Skullmachine/CarteHFProjet4A/README.md

CarteHFProjet3A
===============

Création d'une carte electronique 3A Polytech'tours
