Skullmachine/CarteHFProjet4A/Composants/Commande_Projet_HF.numbers/preview-web.jpg

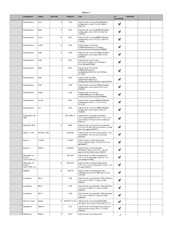
Composants/Commande_Projet_HF.numbers/preview-web.jpg
