Skullmachine/CarteHFProjet4A/CompteRendu/1450908_897423956975424_7267773935941642261_n.jpg

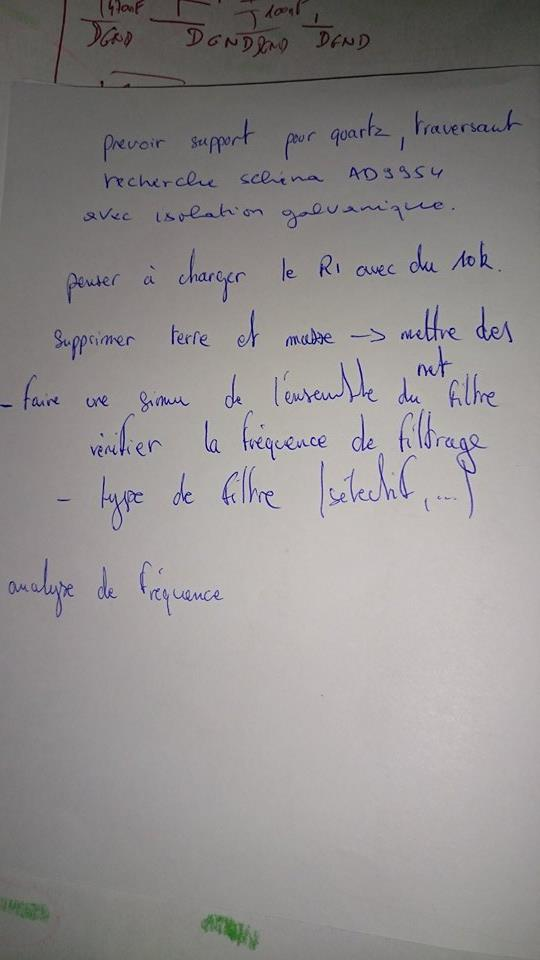
CompteRendu/1450908_897423956975424_7267773935941642261_n.jpg
