Skullmachine/CarteHFProjet4A/CompteRendu/11021189_897423016975518_8215299613850829258_n.jpg

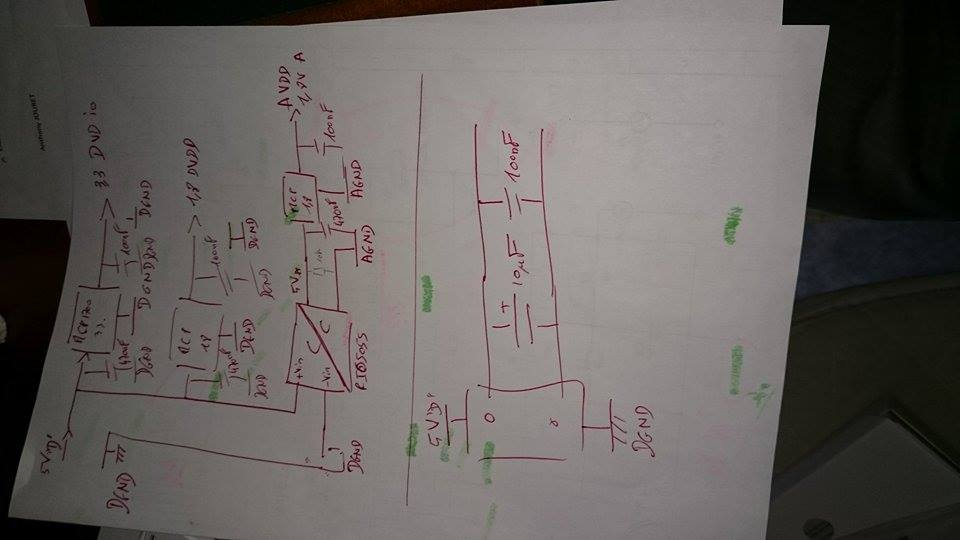
CompteRendu/11021189_897423016975518_8215299613850829258_n.jpg
