Skullmachine/CarteHFProjet4A/CompteRendu/11025787_897423990308754_809297115763388734_n.jpg

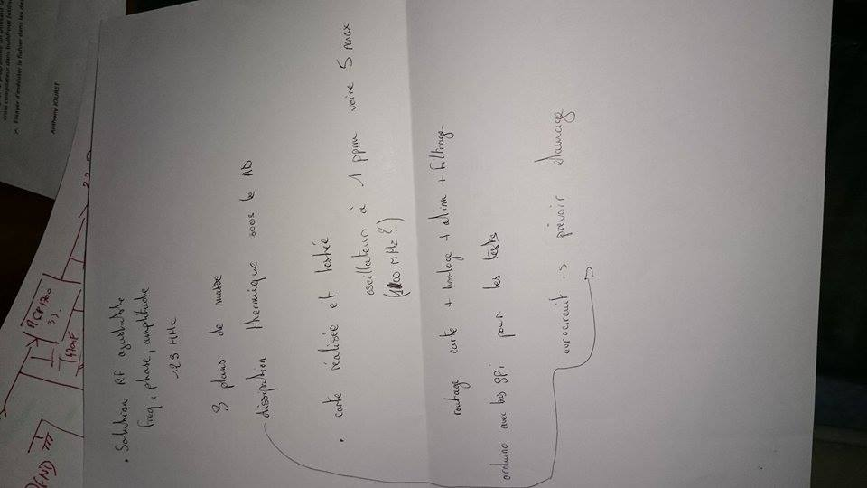
CompteRendu/11025787_897423990308754_809297115763388734_n.jpg
