Skullmachine/CarteHFProjet4A/CompteRendu/modele/images/schema.PNG

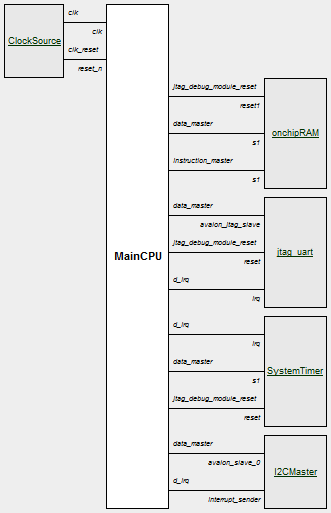
CompteRendu/modele/images/schema.PNG
