Skullmachine/CarteHFProjet4A/CompteRendu/schema_struct_anoté.jpg

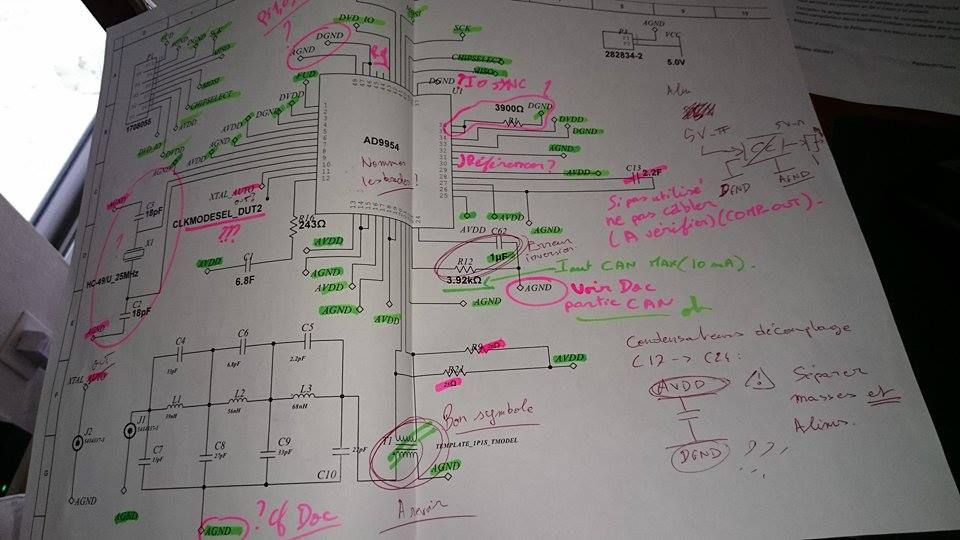
CompteRendu/schema_struct_anoté.jpg
