Skullmachine/CarteHFProjet4A/Composants/Commande Farnell 2.xlsx

Fournisseur | Nom | FARNELL
 | Adresse
Etudiants | Promotion | DII4 |  | Encadrant | Nom | BARANTN
 | Noms | ARTUS | MIKIELA
Projet | Type | Electronique
 | Identifiant (titre ou Id) | 80
N° nom. | Références | Devis | Désignation produits, prestations |  | N°inventaire | Montant unitaire H.T. | Quantité | Montant H.T. | Montant T.V.A. | Montant T.T.C.
 | 2333546RL |  | BOURNS - CR1206-JW-103ELF - RESISTANCE COUCHE EPAISSE 10K 5% 1206 |  |  | 0.045 € | 2 | 0.090 € | 0.018 € | 0.108 €
 | 1754222 |  | VISHAY SPRAGUE - 293D474X9035A2TE3 - CONDENSATEUR TANTALE 470NF 35V BOITIER A |  |  | 0.207 € | 5 | 1.035 € | 0.207 € | 1.242 €
 | 2326128 |  | PANASONIC ELECTRONIC COMPONENTS - EEE1EA100WAR - CONDENSATEUR ELEC ALU 10UF 25V CMS |  |  | 0.160 € | 2 | 0.320 € | 0.064 € | 0.384 €
 |  |  |  |  |  |  |  | 0.000 € | 0.000 € | 0.000 €
Total de la commande |  |  |  |  |  |  |  | 1.445 € | 0.289 € | 1.734 €
Date | 2015-03-03
