Skullmachine/CarteHFProjet4A/Composants/Liste des composants.xlsx

LISTE DES COMPOSANTS POSSEDEE |  |  |  |  |  | LISTE DES COMPOSANTS NECESSAIRES
Désignation | Référence constructeur | SMD | Quantité | Fournisseur | Référence | Désignation | Référence constructeur | SMD | Quantité | Fournisseur | Référence | Empreinte prexistante | Tolérance
 |  |  |  |  |  | Connecteur 2 entrées |  | N | 1 | Farnell | 9731121
Condensateur 10 nF |  | Y | 1 | Farnell | 1612187 | Connecteur 10 entrées |  | N | 2 | Farnell | 9731121
Condensateur 100 nF |  | Y | 20 | Farnell | 1740621 | Condensateur 10 uF |  | Y | 2 | Farnell | 2326128 | Radial - 4 * 5.4 | 20%
Condensateur 33 pF |  | Y | 1 | Farnell | 2210776 | Condensateur 100 nF |  | Y | 14 | Farnell | 1740621 | 0603 | 5%
Condensateur 20 pF |  | Y | 10 | Farnell | 1740573 | Condensateur 10 nF |  | Y | 1 | Farnell | 1612187 | 0805 | 10%
Condensateur 1 uF |  | Y | 1 | Farnell | 2332850 | Condensateur 1 uF |  | Y | 1 | Farnell | 2332850 | 1206 | 5%
Condendateur 6.8 pF |  | Y | 1 | Farnell | 1650904 | Condensateur 2.2 pF |  | Y | 2 | Farnell | 1650898 | 1206 | 10%
Condensateur 2.2 pF |  | Y | 2 | Farnell | 1650898 | Condensateur 13 pF |  | Y | 2 | Farnell | 2218838 | 0402 | 5%
Condensateur 13 pF |  | Y | 2 | Farnell | 2218838 | Condensateur 18 pF |  | Y | 2 | Farnell | 2332866 | 1206 | 5%
Condensateur 10uF |  | Y | 9 | Farnell | 2343193 | Condensateur 22 pF |  | Y | 1 | Farnell | 2219428 | 0603 | 5%
Condensateur 27 pF |  | Y | 1 | Farnell | 2332870 | Condensateur 27 pF |  | Y | 1 | Farnell | 2332870 | 1206 | 5%
Condensateur 22 pF |  | Y | 1 | Farnell | 2219428 | Condensateur 33 pF |  | Y | 1 | Farnell | 2210776 | 0402 | 5%
Condensateur 18 pF |  | Y | 4 | Farnell | 2332866 | Condendateur 6.8 pF |  | Y | 1 | Farnell | 1650904 | 1206 | 10%
 |  |  |  |  |  | Condendateur 470 nF |  | Y | 1 | Farnell |  | 1206 | 10%
Résistance 24 ohm |  | Y | 2 | Farnell | 2395985 | Inductance 39 nH |  | Y | 1 | Farnell | 2286761 | 1008 | 2%
Résistance 3.92 kohm |  | Y | 1 | Farnell | 1160342 | Inductance 56 nH |  | Y | 1 | Farnell | 2286764 | 1008 | 2%
Résistance 3.9 kohm |  | Y | 1 | Farnell | 1652998 | Inductance 68 nH |  | Y | 1 | Farnell | 2286765 | 1008 | 2%
Résistance 390 ohm |  | Y | 1 | Farnell | 2324059 | Résistance 25.5Ω |  | Y | 2 | Farnell | 2330577 | 0402 | 0.10%
Résistance 243 ohm |  | Y | 1 | Farnell | 1653097 | Résistance 243Ω |  | Y | 1 | Farnell | 1653097 | 1206 | 1%
 |  |  |  |  |  | Résistance 10kΩ |  | Y | 4 | Farnell | 2333546RL | 1206 | 5%
Inductance 68nH |  | Y | 1 | Farnell | 2286765 | Résistance 3.92kΩ |  | Y | 1 | Farnell | 1160342 | 0603 | 0.10%
Inductance 39 nH |  | Y | 1 | Farnell | 2286761
Inductance 56 nH |  | Y | 1 | Farnell | 2286764 | Transformateur | T1 - 1T | N | 1 | STMicroelectronics
Régulateur 1.8V | LM1117MP-1.8/NOPB | Y | 2 | Farnell | 1469053 | Synthétiseur numérique direct | AD9954YSVZ | Y | 2 | Farnell | 1581969
Régulateur 3.3V | LM1117MP-3.3 | Y | 1 | Farnell | 9778195
 |  |  |  |  |  | Quartz 25 MHz 10 ppm 18 pF |  | Y | 1 | Farnell | 1842314
Convertisseur USB vers SPI | MCP2210-I/SO | Y | 1 | Farnell | 2078574
Synthétiseur numérique direct | AD9954YSVZ | Y | 2 | Farnell | 1581969 | Régulateur 1.8V | MCP1700T-1802E/TT | Y | 1 | Farnell | 1296591 | SOT 23
Connecteur USB |  | Y | 1 | Farnell | 2293774 | Régulateur 3.3V | MCP1700T-3302E/MB | Y | 2 | Farnell | 1439380 | SOT 89
Crystal 12 MHz 20pF |  | Y | 1 | Farnell | 2063977 | Convertisseur DC/DC | RTM-0505S | Y | 1 | RS | 760-4729
Quartz 25MHz 18 pF |  | Y | 1 | Farnell | 1640907
 |  |  |  |  |  |  | En attente de réception
Transformateur | T1-1T | N | 1 | ST
 |  |  |  |  |  |  | En stock
Connecteur Coaxial SMA Femelle |  | N | 2 | Farnell | 2340512
Pointes de test 8 sorties |  | N | 10 | Farnell | 9731121 |  | Prêt à commander
