Skullmachine/CarteHFProjet4A/Composants/Commande Farnell.xlsx

Fournisseur | Nom | FARNELL
 | Adresse
Etudiants | Promotion | DII4 |  | Encadrant | Nom | BARANTN
 | Noms | ARTUS | MIKIELA
Projet | Type | Electronique
 | Identifiant (titre ou Id) | 80
N° nom. | Références | Devis | Désignation produits, prestations |  | N°inventaire | Montant unitaire H.T. | Quantité | Montant H.T. | Montant T.V.A. | Montant T.T.C.
 | 1439380 |  | MICROCHIP - MCP1700T-3302E/MB - REGULATEUR LDO 0.25A CMS SOT-89-8 |  |  | 0.416 € | 2 | 0.832 € | 0.166 € | 0.998 €
 | 1296591 |  | MICROCHIP - MCP1700T-1802E/TT - REGULATEUR LDO +1.8V 1700 SOT-23-3 |  |  | 0.361 € | 3 | 1.083 € | 0.217 € | 1.300 €
 | 2330577 |  | TE CONNECTIVITY - 9-1879212-9 - RESISTANCE PRECISION 25R5 0.1% 0402 |  |  | 0.458 € | 10 | 4.580 € | 0.916 € | 5.496 €
 | 1842314 |  | TXC - 9C-25.000MEEJ-T - XTAL, 25.000MHZ, 18PF, SMD, HC-49S |  |  | 0.610 € | 1 | 0.610 € | 0.122 € | 0.732 €
Total de la commande |  |  |  |  |  |  |  | 6.495 € | 1.299 € | 7.794 €
Date | 2015-02-24
