Skullmachine/CarteHFProjet4A/Composants/Commande RS.xlsx

Fournisseur | Nom | RS
 | Adresse
Etudiants | Promotion | DII4 |  | Encadrant | Nom | BARANTN
 | Noms | ARTUS | MIKIELA
Projet | Type | Electronique
 | Identifiant (titre ou Id) | 80
N° nom. | Références | Devis | Désignation produits, prestations |  | N°inventaire | Montant unitaire H.T. | Quantité | Montant H.T. | Montant T.V.A. | Montant T.T.C.
 | 760-4729 |  | RTM-0505S |  |  | 8.960 € | 2 | 17.920 € | 3.584 € | 21.504 €
 |  |  |  |  |  |  |  | 0.000 € | 0.000 € | 0.000 €
 |  |  |  |  |  |  |  | 0.000 € | 0.000 € | 0.000 €
Total de la commande |  |  |  |  |  |  |  | 17.920 € | 3.584 € | 21.504 €
Date | 2015-02-02
