Skullmachine/CarteHFProjet4A/Documentations/schema_structurel.pdf

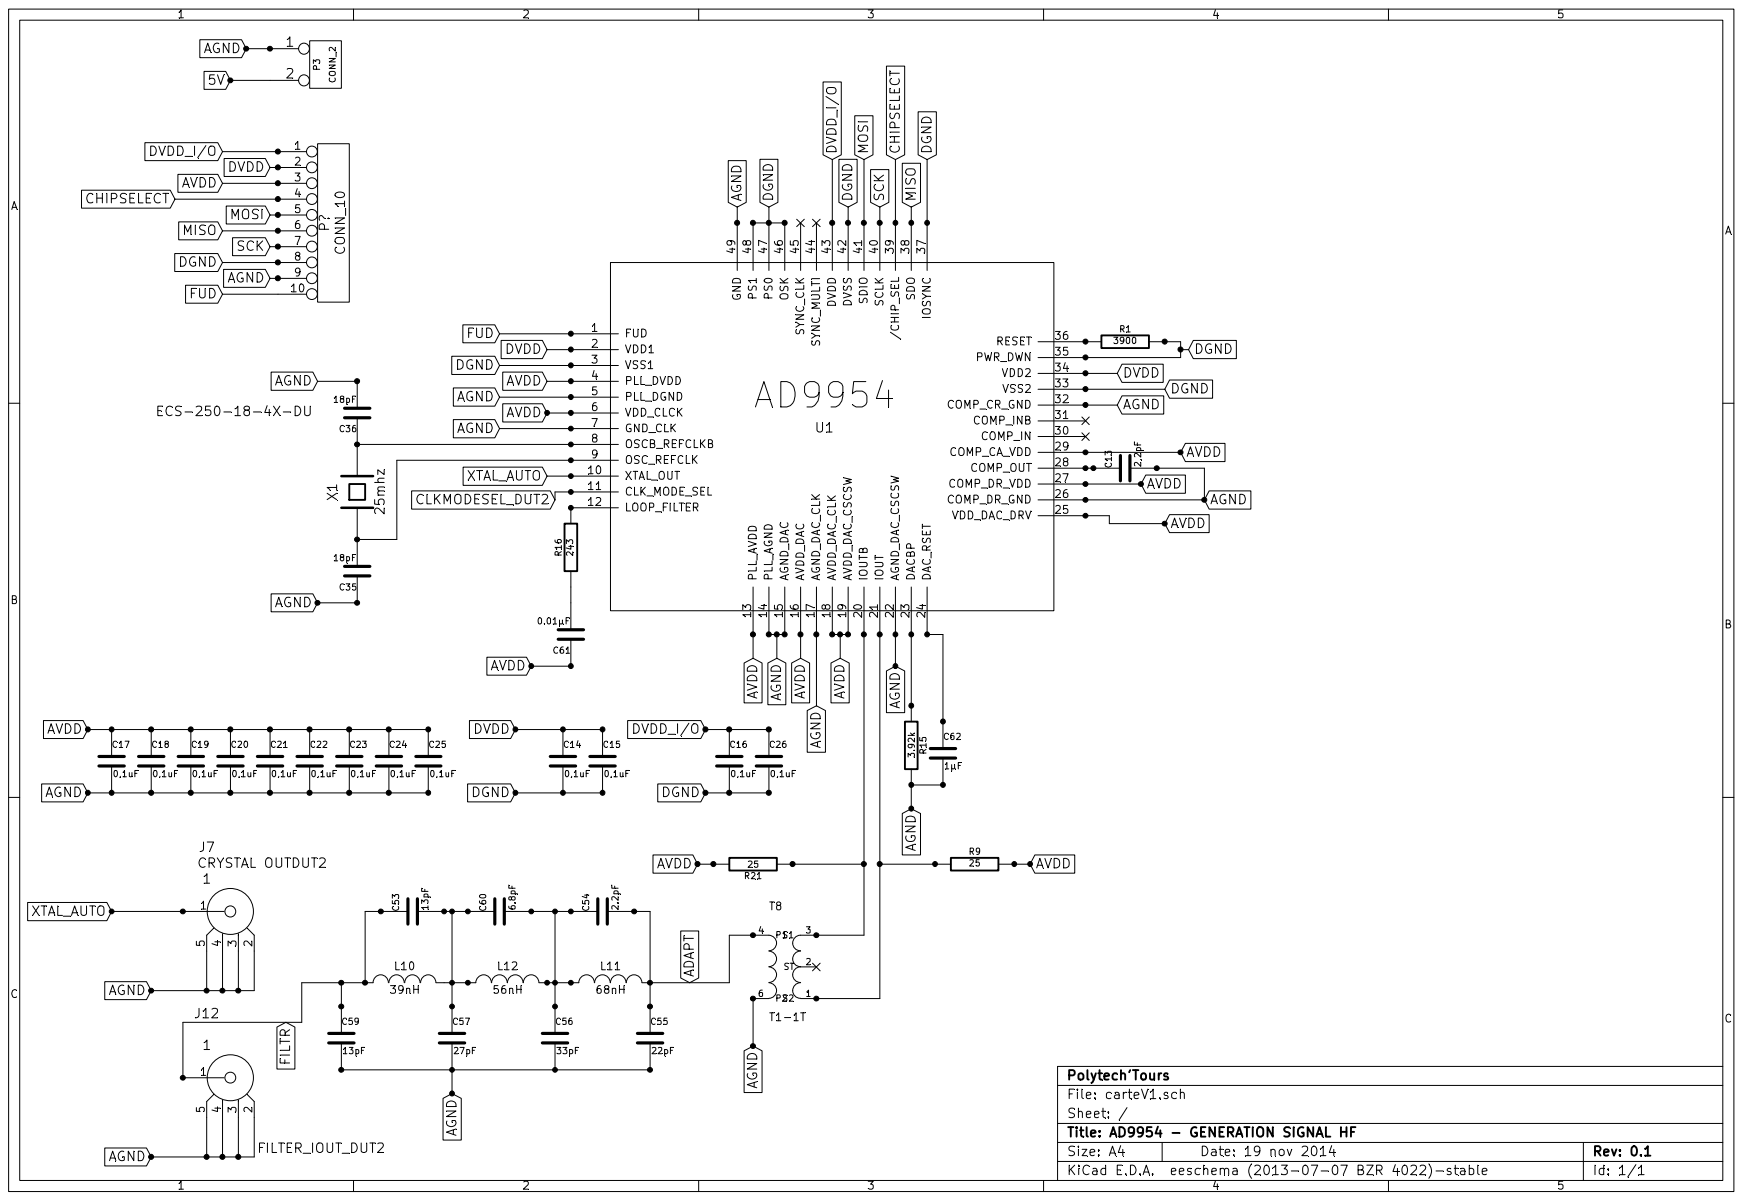
[picture p34: page 1]
