Skullmachine/CarteHFProjet4A/(list of files, drawings)

Other design files:
Projet Multi Sim/AD9954.ms13
Projet Multi Sim/Alim AD9954.ms13
Projet Multi Sim/carte_hf.ms13
Projet Multi Sim/CarteHFProjet4A Routage.ms13
Projet Multi Sim/CarteHFProjet4A.ms13
Projet Multi Sim/Filtre.ms13
