Skullmachine/CarteHFProjet4A/Projet Kicad/carteV1.kicad_pcb

## KiCad design Projet Kicad/carteV1.kicad_pcb (2015-02-01)

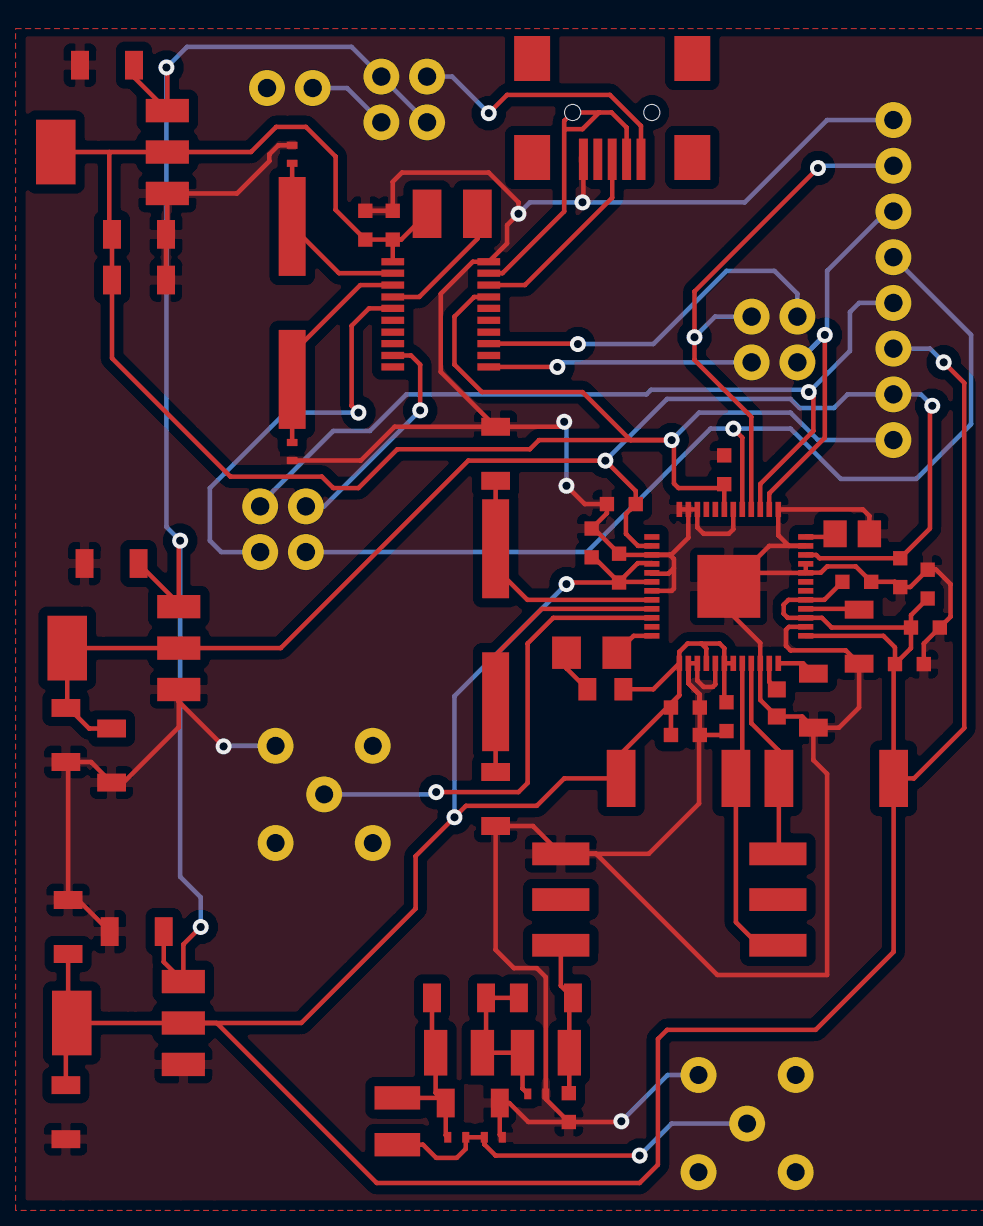
[picture p35: board carteV1.kicad_pcb from above]

Board: 2 copper layers, 62 parts (0 on the bottom side), 35 nets.

Parts:
C1, C2, C3, C4, C5, C6, C7, C8, C9: 10uF; 1206
C10, C11: 20pF; 0402
C12, C14, C15, C16, C17, C18, C19, C20, C21, C22, C23, C24, C25, C26: 0,1uF; 0603
C13: 2,2pF; 1206
C35, C36: 18pF; 1206
C53, C59: 13pF; 0402
C54: 2.2pF; 1206
C55: 22pF; 0603
C56: 33pF; 0402
C57: 27pF; 1206
C60: 6.8pF; 1206
C61: 0.01μF; 0805
C62: 1μF; 1206
CON1: USB-MINI-B; USB_MINI_B
J7: CRYSTAL OUTDUT2; SMA
J12: FILTER_IOUT_DUT2; SMA
L10: 39nH; 1008CS
L11: 68nH; 1008CS
L12: 56nH; 1008CS
P1, P2, P4: CONN_2X2; BARRETTE_2x2V
P3: CONN_2; BARRETTE_2V
P5: CONN_8; BARRETTE_8V
R1: 3900; r_0805
R9, R21: 25; r_2512
R15: 3.92k; r_0603
R16: 243; r_1206
R1001: 390; r_1210
T8: T1-1T; KK81
U1: AD9954; TQFP48
U2, U3: LM1117MP-1.8; SOT-223
U4: LM1117MP-3.3; SOT-223
U5: MCP2210-SO; SSOP20
X1: 25mhz; HC49/US
X2: 12mhz; HC49/US

Connections:
5V: C1.1, C4.1, C7.1, P2.1, P2.3, U2.3, U3.3, U4.3
/OSC: C11.1, U5.3, X2.1
AVDD: C8.1, C9.1, C17.1, C18.1, C19.1, C20.1, C21.1, C22.1, C23.1, C24.1, C25.1, C61.1, P5.3, R9.2, R21.2, U1.4, U1.6, U1.13, U1.16, U1.18, U1.19, U1.25, U1.27, U1.29, U3.2, U3.4
CHIPSELECT: P4.3, P5.4, U1.39
D+: CON1.2, U5.19
D-: CON1.3, U5.18
DVDD: C5.1, C6.1, C14.1, C15.1, P5.2, U1.2, U1.34, U2.2, U2.4
DVDD_I/O: C2.1, C3.1, C12.2, C16.1, C26.1, P5.1, R1001.1, U1.43, U4.2, U4.4, U5.1, U5.17
GND: C1.2, C2.2, C3.2, C4.2, C5.2, C6.2, C7.2, C8.2, C9.2, C10.2, C11.2, C12.1, C13.2, C14.2, C15.2, C16.2, C17.2, C18.2, C19.2, C20.2, C21.2, C22.2, C23.2, C24.2, C25.2, C26.2, C35.1, C36.2, C55.2, C56.2, C57.2, C59.2, C62.2, CON1.5, J7.2, J7.3, J7.4, J7.5, J12.2, J12.3, J12.4, J12.5, P3.1, P5.8, R1.2, R15.2, T8.6, U1.3, U1.5, U1.7, U1.14, U1.15, U1.17, U1.22, U1.26, U1.32, U1.33, U1.35, U1.37, U1.42, U1.46, U1.47, U1.48, U1.49, U2.1, U3.1, U4.1, U5.20
MISO: P1.3, P5.6, U1.38
MOSI: P4.1, P5.5, U1.41
unnamed: C61.2, R16.1
unnamed: R16.2, U1.12
unnamed: C36.1, U1.8, X1.2
unnamed: C35.2, U1.9, X1.1
unnamed: P1.4, U5.13
unnamed: P4.2, U5.9
unnamed: R1.1, U1.36
unnamed: P1.2, U5.11
unnamed: C53.1, C59.1, J12.1, L10.1
unnamed: C53.2, C57.1, C60.1, L10.2, L12.1
unnamed: C54.1, C56.1, C60.2, L11.1, L12.2
unnamed: C13.1, U1.28
unnamed: CON1.1, P2.4
unnamed: P2.2, P3.2
unnamed: C62.1, U1.24
unnamed: C54.2, C55.1, L11.2, T8.4
unnamed: P4.4, U5.5
unnamed: R15.1, U1.23
unnamed: R21.1, T8.3, U1.20
unnamed: R9.1, T8.1, U1.21
unnamed: R1001.2, U5.4
OSC: C10.1, U5.2, X2.2
SCK: P1.1, P5.7, U1.40
XTAL_AUTO: J7.1, U1.10
