Skullmachine/CarteHFProjet4A/(commit log)

2014-05-18 Ajout GND AVDD
2014-05-18 Mise en forme de la page
    [carteV1.sch]
2014-05-18 Rajout de la partie XTAL
    [carteV1.sch]
2014-05-18 Avancement
    -Rajout d’une partie du filtrage..
    [$carteV1.sch]
2014-05-19 Installation du Quartz
    -Détermination des capa
    -Determination du quartz
    [$carteV1.sch]
2014-05-19 Avancement
    - Ajout de la lib MAX.. SPI/USB
    - Ajout d’un connecteur MINI USB
    -Ajout d’un convertisseur CC … plus qu’a le câblé
    [$carteV1.sch, carteV1.sch]
2014-05-19 Modification : Alimentation & USB
    -Ajout des 2 alimentations + ref
    -Modification du MAX
    [carteV1.sch]
2014-05-20 USB changement PARTS
    -Utilisation du MCP2210 ( SPI-MASTER)
    -Changement du Quartz
    [carteV1.sch]
2014-05-20 Alimentation
    -Ajout des deux montages
    -Fin du raccordement du microC
    [carteV1.sch]
2014-05-20 Ajout des titres
    [carteV1.sch]
2014-05-21 Réparation des fils
    [carteV1.sch]
2014-05-21 Reparation fils
    [carteV1.sch]
2014-05-22 Numérotation des composants
    [carteV1.sch]
2014-05-22 Ajout des footprints et liaisons
    [Composant.xlsx, carteV1.sch]
2014-05-22 Add MP2210 documentation and supply MP2210 with 3,3V
    [carteV1.sch]
2014-05-26 Ajout jumper
    [carteV1.sch]
2014-05-27 modification ad9954
    [$carteV1.sch, carteV1.sch]
2014-05-27 modif AD9954
    [$carteV1.sch, carteV1.sch]
2014-05-27 Modif pcb
2014-06-03 Remove the test point of ref_clk
    [carteV1.sch]
2014-06-05 Insertion capa pour découplage + new footprint
    [carteV1.sch]
2014-06-05 Modify the connector to power in 5V
    [carteV1.sch]
2014-06-13 Ajout du fichier pour la commande, typon terminé avec plan de masse
    [carteV1.kicad_pcb, carteV1.sch]
2014-06-15 Final version without the I/O update pin connected
    [carteV1.kicad_pcb, carteV1.sch]
2014-11-10 Ajout rapport & modification schéma structurel
    [carteV1.sch]
2014-11-19 Modification du schéma structurel: - Ajout des 3 alimentations à découpage
    [carteV1.sch]
2015-02-01 Ajout liste des composants possédés
    [Liste des composants possédée.xlsx]
2015-02-01 Ajout fichier commande de composants
    [Commande de composants.xlsx]
2015-02-01 Ajout schéma structurel alimentation AD9954
    Compatible Multisim v13
    [Alim AD9954.ms13]
2015-02-01 Maj schéma structurel Kicad
    [carteV1.sch]
2015-02-05 Maj schema structurel
    [AD9954.ms13, CarteHFProjet4A.ms13]
2015-02-05 Maj AD9954
    [AD9954.ms13, Liste des composants.xlsx]
2015-02-18 Finalisation Schema structurel
    [AD9954.ms13, Alim AD9954.ms13, CarteHFProjet4A.ms13, Filtre.ms13, carte_hf.ms13]
2015-02-18 Correction netlist Source
    [AD9954.ms13, CarteHFProjet4A.ms13]
2015-02-21 Maj Commande Farnell
    [Commande Farnell.xlsx]
2015-02-24 MAJ CartProjetHF4A
    [CarteHFProjet4A.ms13]
2015-02-24 MAJ CarteProjetHF4A
    [CarteHFProjet4A.ms13, Filtre.ms13]
2015-02-24 MAJ
    supression resistance 3.9 k et polarisation C13
    [CarteHFProjet4A.ms13]
2015-02-24 Màj CarteProjetHF4A
    [CarteHFProjet4A.ms13]
2015-02-24 MAJ CarteProjetHF4A
    Nom des pins AD9959
    [CarteHFProjet4A.ms13]
2015-02-24 Màj schéma structurel
    [CarteHFProjet4A.ms13]
2015-02-25 Màj Commandes
    [Commande Farnell 2.xlsx, Commande Farnell.xlsx, Liste des composants.xlsx]
2015-02-25 Màj des schémas
    [CarteHFProjet4A.ms13, Filtre.ms13]
2015-02-28 Ajout liste composants pour Altais
    [ListeComposants.xlsx]
2015-03-06 Empreintes des composants r Please enter the commit message for your changes. Lines starting
    [CarteHFProjet4A.ms13, Commande Farnell 2.xlsx, Liste des composants.xlsx]
